Maltheren/Beerduino/README.md

# Beerduino
A functional arduino uno with a build in bottle opener.
