Maltheren/Beerduino/rev_1/Beerduino.kicad_pcb

## KiCad design rev_1/Beerduino.kicad_pcb (2025-07-03, an earlier design)

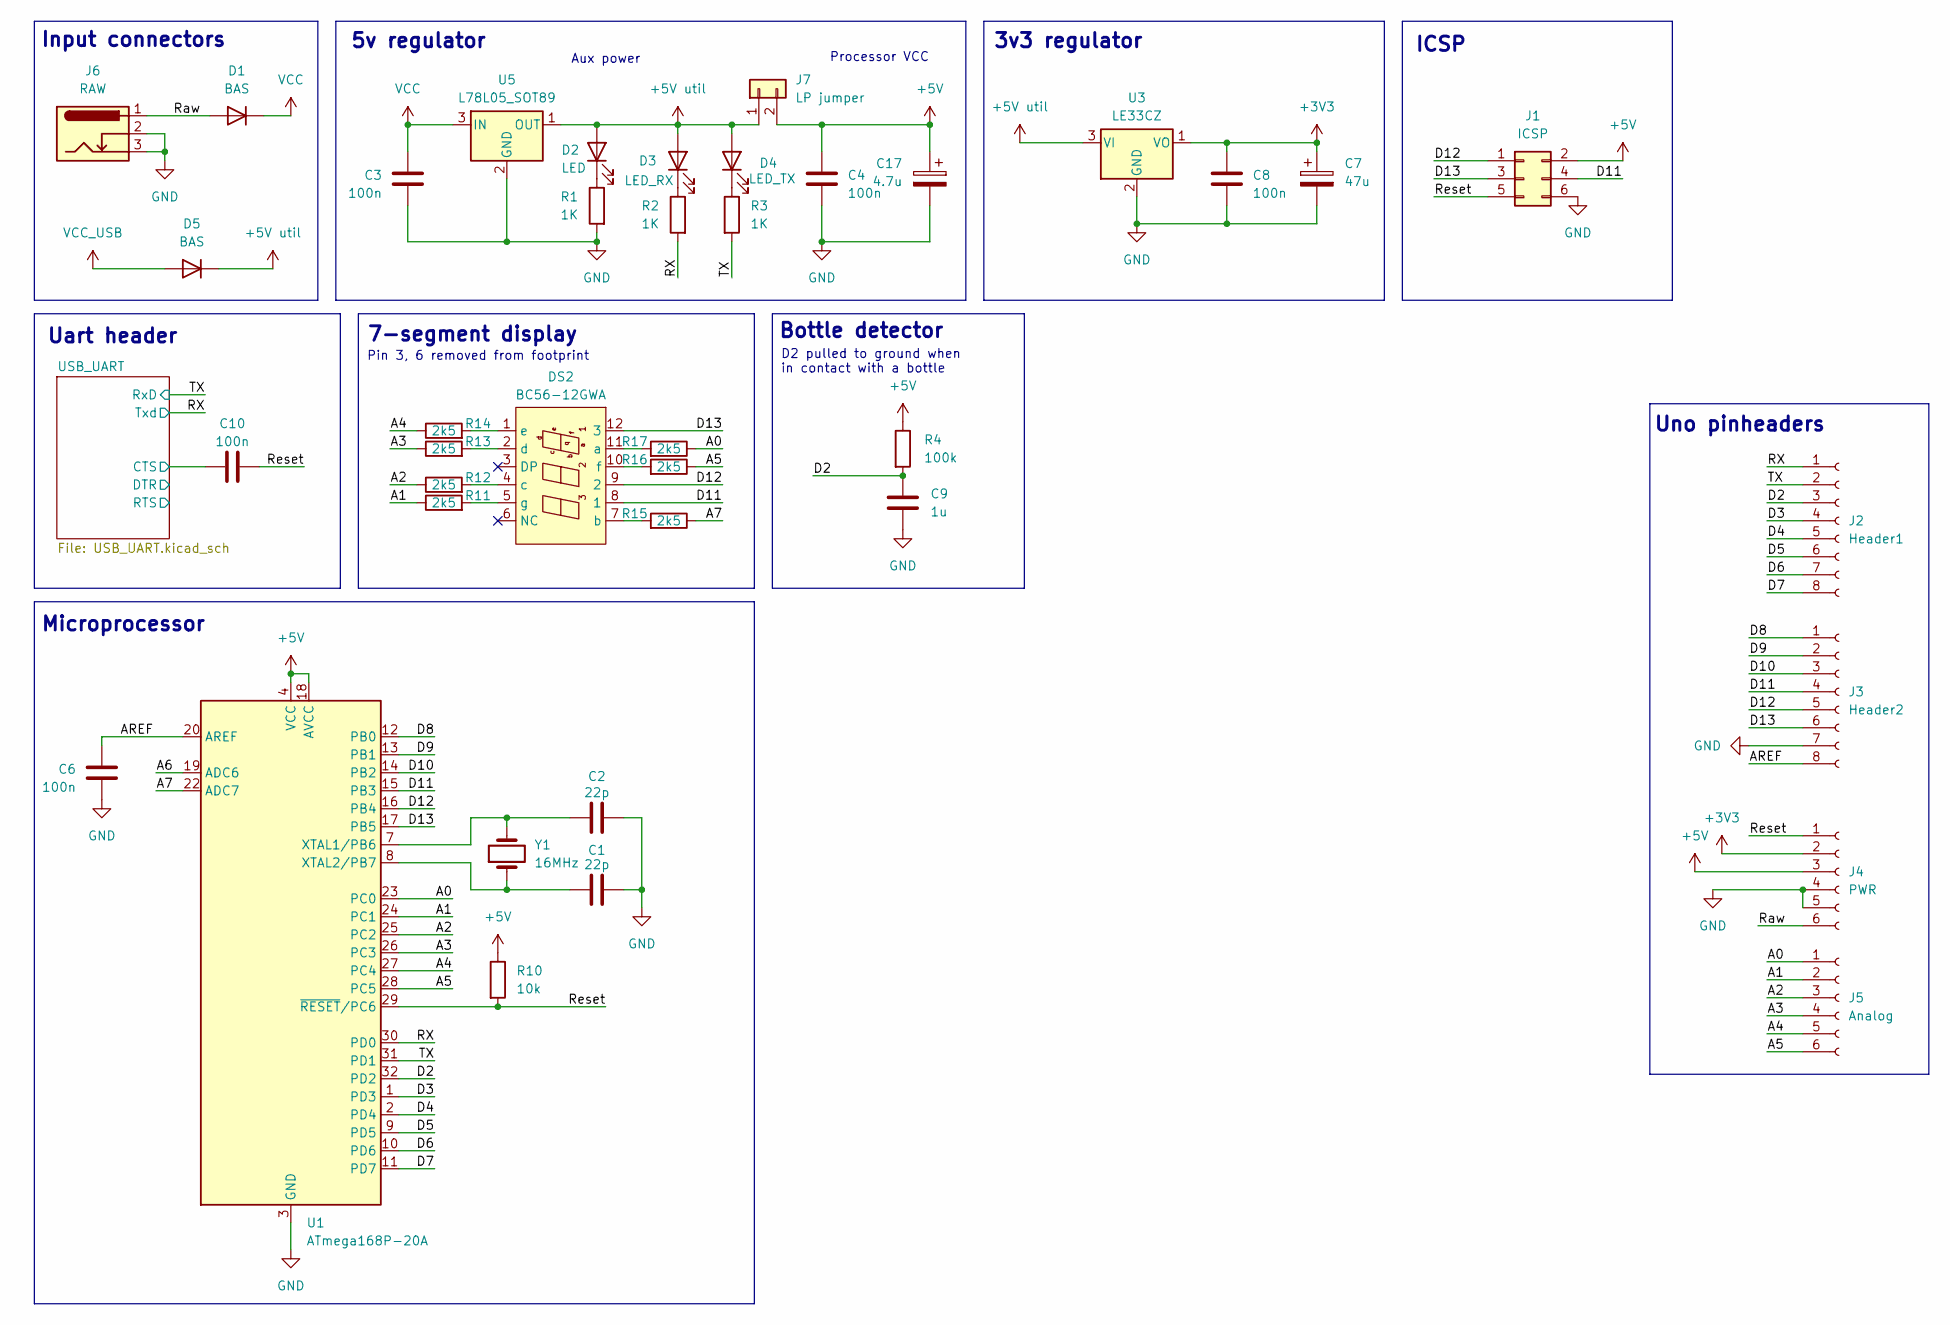
[picture p1: schematic Beerduino.kicad_sch]

Parts:
C1, C2: 22p; C_0603_1608Metric_Pad1.08x0.95mm_HandSolder
C3, C4, C6, C8, C10: 100n; C_0603_1608Metric_Pad1.08x0.95mm_HandSolder
C7: 47u; CP_Radial_D5.0mm_P2.50mm
C9: 1u; C_0603_1608Metric_Pad1.08x0.95mm_HandSolder
C17: 4.7u; CP_EIA-3528-15_AVX-H_HandSolder
D1, D5: BAS; D_SOD-323_HandSoldering
D2: LED; LED_0805_2012Metric_Pad1.15x1.40mm_HandSolder
D3: LED_RX; LED_0805_2012Metric_Pad1.15x1.40mm_HandSolder
D4: LED_TX; LED_0805_2012Metric_Pad1.15x1.40mm_HandSolder
DS2: BC56-12GWA; 3digit
J1: ICSP; PinHeader_2x03_P2.54mm_Vertical
J2: Header1; PinSocket_1x08_P2.54mm_Vertical
J3: Header2; PinSocket_1x08_P2.54mm_Vertical
J4: PWR; PinHeader_1x06_P2.54mm_Vertical
J5: Analog; PinHeader_1x06_P2.54mm_Vertical
J6: RAW; BarrelJack_Horizontal
J7: LP jumper; PinHeader_1x02_P2.54mm_Vertical
R1, R2, R3: 1K; R_0603_1608Metric_Pad0.98x0.95mm_HandSolder
R4: 100k; R_0603_1608Metric_Pad0.98x0.95mm_HandSolder
R10: 10k; R_0603_1608Metric_Pad0.98x0.95mm_HandSolder
R11, R12, R13, R14, R15, R16, R17: 2k5; R_0603_1608Metric_Pad0.98x0.95mm_HandSolder
U1: ATmega168P-20A; TQFP-32_7x7mm_P0.8mm
U3: LE33CZ; TO-92_HandSolder
U5: L78L05_SOT89; SOT-89-3
Y1: 16MHz; Crystal_SMD_HC49-SD

Connections:
+3V3: C7.1, C8.1, J4.2, U3.1 (VO)
+5V: C4.1, C17.1, J1.2, J4.3, J7.2, R4.1, R10.1, U1.4 (VCC), U1.6 (VCC), U1.18 (AVCC)
+5V util: D2.2 (A), D3.2 (A), D4.2 (A), D5.1 (K), J7.1, U3.3 (VI), U5.1 (OUT)
/A0: J5.1, R17.1, U1.23 (PC0)
/A1: J5.2, R11.1, U1.24 (PC1)
/A2: J5.3, R12.1, U1.25 (PC2)
/A3: J5.4, R13.1, U1.26 (PC3)
/A4: J5.5, R14.1, U1.27 (PC4)
/A5: J5.6, R16.1, U1.28 (PC5)
/A6: U1.19 (ADC6)
/A7: R15.1, U1.22 (ADC7)
/AREF: C6.1, J3.8, U1.20 (AREF)
/D2: C9.1, J2.3, R4.2, U1.32 (PD2)
/D3: J2.4, U1.1 (PD3)
/D4: J2.5, U1.2 (PD4)
/D5: J2.6, U1.9 (PD5)
/D6: J2.7, U1.10 (PD6)
/D7: J2.8, U1.11 (PD7)
/D8: J3.1, U1.12 (PB0)
/D9: J3.2, U1.13 (PB1)
/D10: J3.3, U1.14 (PB2)
/D11: DS2.8 (1), J1.4, J3.4, U1.15 (PB3)
/D12: DS2.9 (2), J1.1, J3.5, U1.16 (PB4)
/D13: DS2.12 (3), J1.3, J3.6, U1.17 (PB5)
/RX: J2.1, R2.2, U1.30 (PD0); also elsewhere on the board
/Raw: D1.2 (A), J4.6, J6.1
/Reset: C10.1, J1.5, J4.1, R10.2, U1.29 (~RESET/PC6)
/TX: J2.2, R3.2, U1.31 (PD1); also elsewhere on the board
/USB_UART/CTS: C10.2; also elsewhere on the board
GND: C1.2, C2.2, C3.2, C4.2, C6.2, C7.2, C8.2, C9.2, C17.2, J1.6, J3.7, J4.4, J4.5, J6.2, J6.3, R1.2, U1.3 (GND), U1.5 (GND), U1.21 (GND), U3.2 (GND), U5.2 (GND); also elsewhere on the board
unnamed: D2.1 (K), R1.1
unnamed: D3.1 (K), R2.1
unnamed: D4.1 (K), R3.1
unnamed: DS2.11 (a), R17.2
unnamed: DS2.7 (b), R15.2
unnamed: DS2.4 (c), R12.2
unnamed: DS2.2 (d), R13.2
unnamed: DS2.1 (e), R14.2
unnamed: DS2.10 (f), R16.2
unnamed: DS2.5 (g), R11.2
unnamed: C2.1, U1.7 (XTAL1/PB6), Y1.2
unnamed: C1.1, U1.8 (XTAL2/PB7), Y1.1
VCC: C3.1, D1.1 (K), U5.3 (IN)
VCC_USB: D5.2 (A); also elsewhere on the board

Notes on the sheet:
Aux power
Pin 3, 6 removed from footprint
Microprocessor
3v3 regulator
Uart header
Bottle detector
5v regulator
ICSP
Uno pinheaders
Processor VCC
7-segment display
Input connectors
D2 pulled to ground when in contact with a bottle

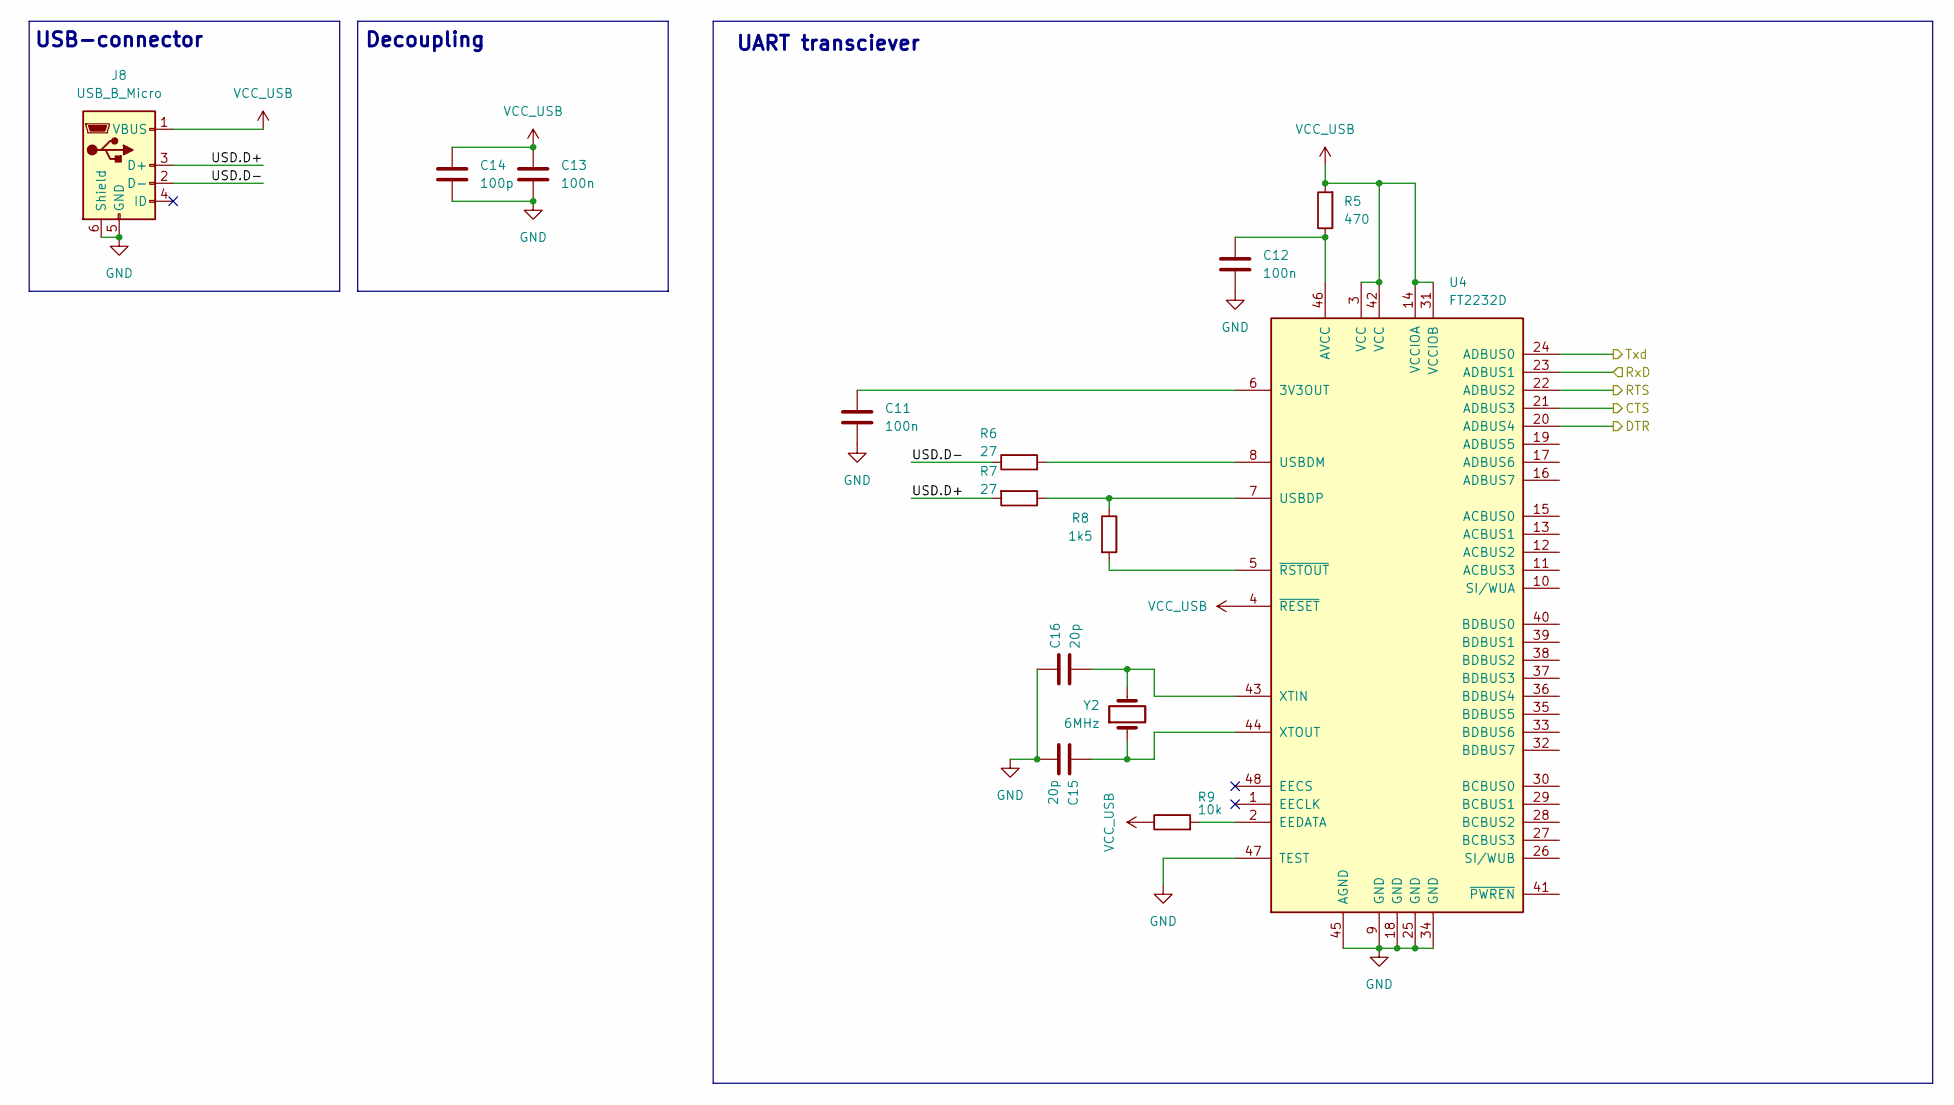
[picture p2: schematic USB_UART.kicad_sch, Beerduino]

Parts:
C11, C12, C13: 100n; C_0603_1608Metric_Pad1.08x0.95mm_HandSolder
C14: 100p; C_0603_1608Metric_Pad1.08x0.95mm_HandSolder
C15, C16: 20p; C_0603_1608Metric
J8: USB_B_Micro; USB_Micro-B_Wuerth_629105150521_CircularHoles
R5: 470; C_0603_1608Metric_Pad1.08x0.95mm_HandSolder
R6, R7: 27; R_0603_1608Metric_Pad0.98x0.95mm_HandSolder
R8: 1k5; R_0603_1608Metric_Pad0.98x0.95mm_HandSolder
R9: 10k; R_0603_1608Metric_Pad0.98x0.95mm_HandSolder
U4: FT2232D; LQFP-48_7x7mm_P0.5mm
Y2: 6MHz; Crystal_SMD_HC49-SD

Connections:
/RX: U4.24 (ADBUS0); also elsewhere on the board
/TX: U4.23 (ADBUS1); also elsewhere on the board
/USB_UART/CTS: U4.21 (ADBUS3); also elsewhere on the board
/USB_UART/DTR: U4.20 (ADBUS4)
/USB_UART/RTS: U4.22 (ADBUS2)
/USB_UART/USD.D+: J8.3 (D+), R7.2
/USB_UART/USD.D-: J8.2 (D-), R6.1
GND: C11.2, C12.2, C13.2, C14.2, C15.1, C16.2, J8.5 (GND), J8.6 (Shield), U4.9 (GND), U4.18 (GND), U4.25 (GND), U4.34 (GND), U4.45 (AGND), U4.47 (TEST); also elsewhere on the board
unnamed: C11.1, U4.6 (3V3OUT)
unnamed: C12.1, R5.1, U4.46 (AVCC)
unnamed: R9.2, U4.2 (EEDATA)
unnamed: R6.2, U4.8 (USBDM)
unnamed: R7.1, R8.1, U4.7 (USBDP)
unnamed: C16.1, U4.43 (XTIN), Y2.2
unnamed: C15.2, U4.44 (XTOUT), Y2.1
unnamed: R8.2, U4.5 (~RSTOUT)
VCC_USB: C13.1, C14.1, J8.1 (VBUS), R5.2, R9.1, U4.3 (VCC), U4.4 (~RESET), U4.14 (VCCIOA), U4.31 (VCCIOB), U4.42 (VCC); also elsewhere on the board

Notes on the sheet:
Decoupling
UART transciever
USB-connector

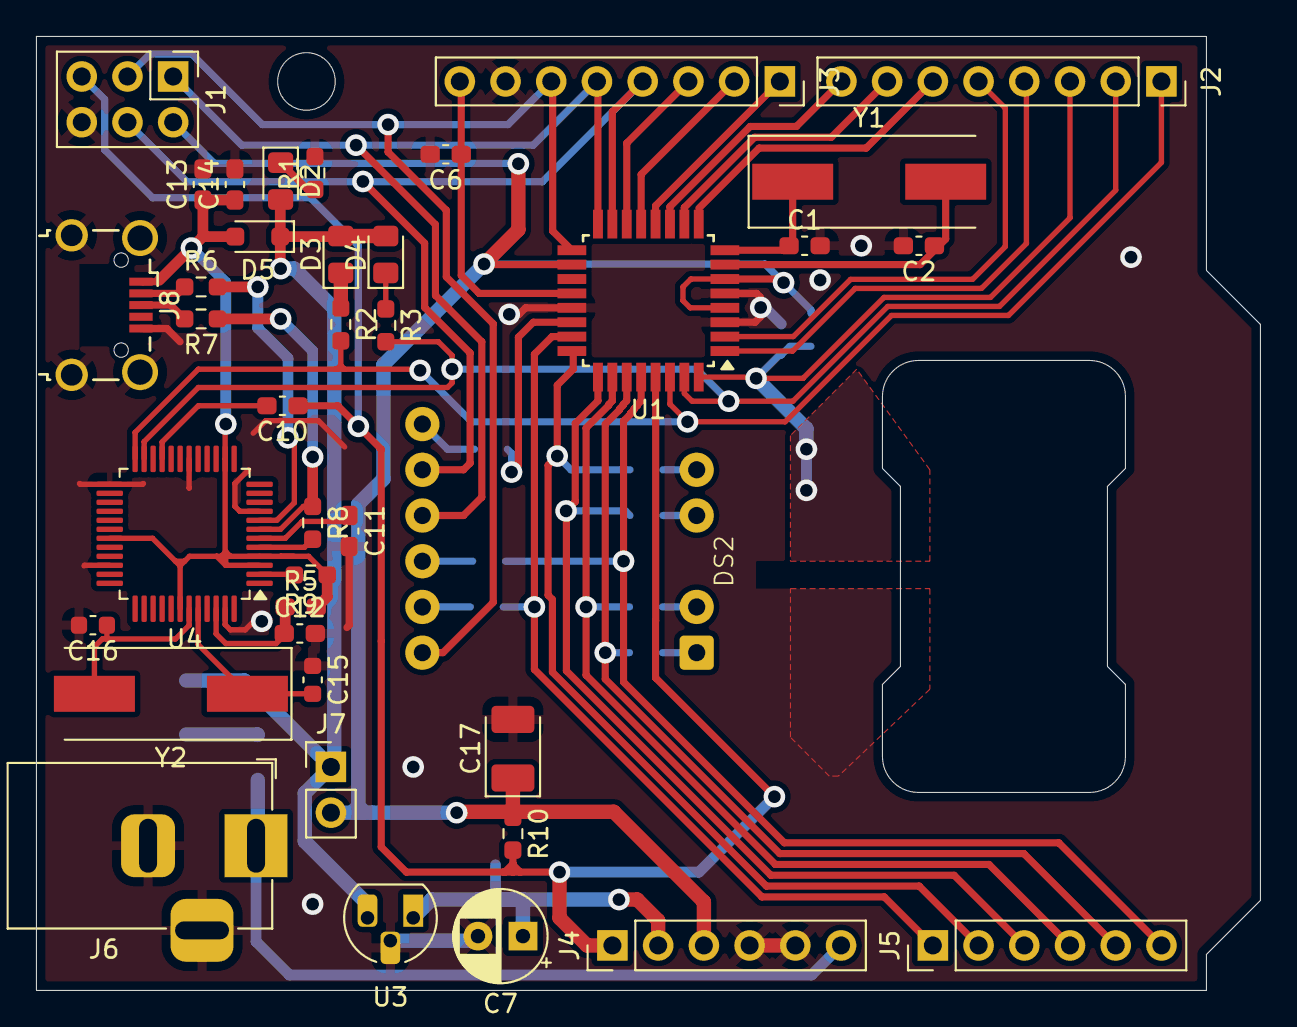
[picture p3: board Beerduino.kicad_pcb from above]

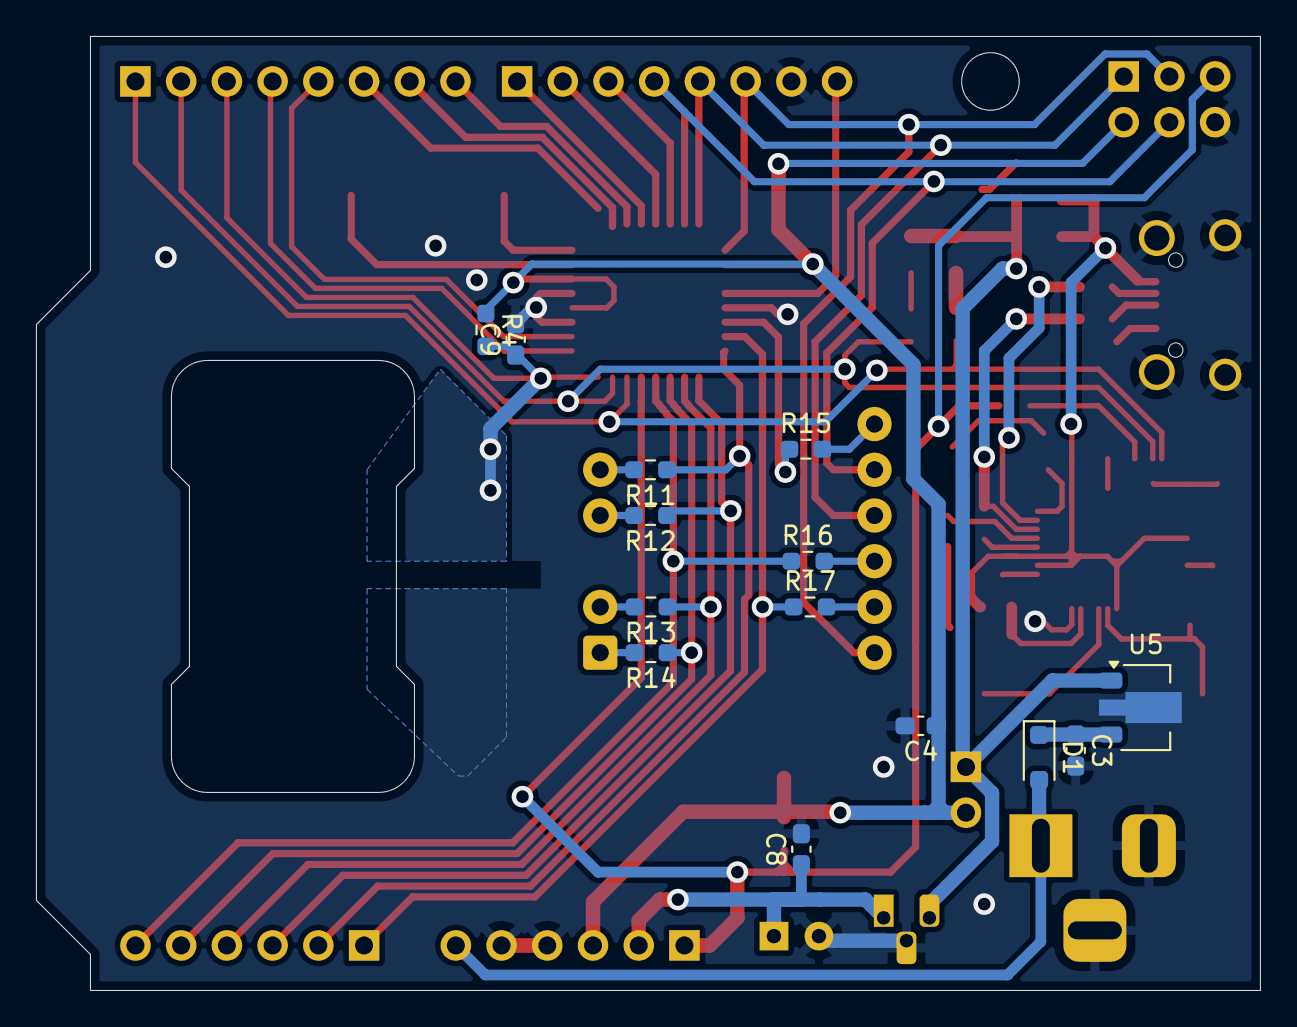
[picture p4: board Beerduino.kicad_pcb from below]

Board: 2 copper layers, 68.0 x 53.0 mm, 53 parts (14 on the bottom side), 53 nets.
