Maltheren/Beerduino/(commit log)

2025-07-03 rev1 initial
    [BC56-12GWA.stp, Beerduino.kicad_pcb, Beerduino.kicad_sch, USB_UART.kicad_sch]
2025-07-05 Initial rev2
    [Beerduino_2.kicad_pcb, Beerduino_2.kicad_sch]
